gralco/GLCD/README.md

Reimplementation of the RepRapDiscount Full Graphic Smart Controller in KiCad
