gralco/GLCD/BoM/GLCD.csv

Reference | Value | Footprint | Datasheet | MFG Name | MFG Part Num | Distrib PN | Distrib Link | Tolerance | Others | More | MFG Link | Drawing
Q1 | BC817-40 | TO_SOT_Packages_SMD:SOT-23_Handsoldering | http://www.diodes.com/_files/datasheets/ds11107.pdf | Diodes Incorporated | BC817-40-7-F | 621-BC817-40-7-F | http://www.mouser.com/ProductDetail/Diodes-Incorporated/BC817-40-7-F/?qs=rGAXPo9uwV11o%252bqBQVUw0g%3D%3D
SP1 | SPEAKER | Buzzers_Beepers:Buzzer_12x9.5RM7.6 | http://www.puiaudio.com/pdf/AI-1223-TWT-5V-R.pdf | CUI | AI-1223-TWT-5V-R | 665-AI-1223TWT5VR | http://www.mouser.com/ProductDetail/PUI-Audio/AI-1223-TWT-5V-R/?qs=hFHXi4OlQrkyrRn%252bNLipFQ%3D%3D | - | http://www.mouser.com/Electromechanical/Audio-Devices/Audio-Indicators-Alerts/_/N-awp3t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
IC1 | 74HC4050 | SMD_Packages:SO-16-N | http://www.nxp.com/documents/data_sheet/74HC4050.pdf | Texas Instruments | CD74HC4050M96 | 595-CD74HC4050M96 | http://www.mouser.com/ProductDetail/Texas-Instruments/CD74HC4050M96/
EXP2 | CONN_02X05 | Connect:IDC_Header_Straight_10pins | http://multimedia.3m.com/mws/media/22504O/3mtm-100-in-loprof-hdr-100x-100strt-ra-4-wall-ts0818.pdf | 3M Electronic Solutions Division | 30310-6002HB | 517-30310-6002 | http://www.mouser.com/ProductDetail/3M-Electronic-Solutions-Division/30310-6002HB/ | - | http://www.mouser.com/Connectors/Headers-Wire-Housings/_/N-ay0lo | http://www.digikey.com/product-search/en/connectors-interconnects/rectangular-connectors-headers-male-pins/1442547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
C1 | 100nF | Capacitors_SMD:C_0805_HandSoldering | http://datasheets.avx.com/X7RDielectric.pdf | AVX | 08055C104KAT2A | 581-08055C104K | http://www.mouser.com/ProductDetail/AVX/08055C104KAT2A/ | 10% | http://www.mouser.com/Passive-Components/Capacitors/Ceramic-Capacitors/MLCCs-Multilayer-Ceramic-Capacitors/Multilayer-Ceramic-Capacitors-MLCC-SMD-SMT/_/N-bkrd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
R1 | 1kΩ | Resistors_SMD:R_0805_HandSoldering | http://www.vishay.com/docs/20035/dcrcwe3.pdf | Vishay / Dale | CRCW08051K00FKEA | 71-CRCW0805-1.0K-E3 | http://www.mouser.com/ProductDetail/Vishay-Dale/CRCW08051K00FKEA/ | 1% | http://www.mouser.com/Passive-Components/Resistors/SMD-Resistors-Chip-Resistors/Thick-Film-Resistors/_/N-7h7yz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
EXP1 | CONN_02X05 | Connect:IDC_Header_Straight_10pins | http://multimedia.3m.com/mws/media/22504O/3mtm-100-in-loprof-hdr-100x-100strt-ra-4-wall-ts0818.pdf | 3M Electronic Solutions Division | 30310-6002HB | 517-30310-6002 | http://www.mouser.com/ProductDetail/3M-Electronic-Solutions-Division/30310-6002HB/ | - | http://www.mouser.com/Connectors/Headers-Wire-Housings/_/N-ay0lo | http://www.digikey.com/product-search/en/connectors-interconnects/rectangular-connectors-headers-male-pins/1442547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
U1 | MIC5209-3.3YS | TO_SOT_Packages_SMD:SOT-223 | http://ww1.microchip.com/downloads/en/DeviceDoc/mic5209.pdf | Micrel | MIC5209-3.3YS-TR | 998-MIC5209-3.3YSTR | http://www.mouser.com/ProductDetail/Microchip-Technology-Micrel/MIC5209-33YS-TR/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
C3 | 100nF | Capacitors_SMD:C_0805_HandSoldering | http://datasheets.avx.com/X7RDielectric.pdf | AVX | 08055C104KAT2A | 581-08055C104K | http://www.mouser.com/ProductDetail/AVX/08055C104KAT2A/ | 10% | http://www.mouser.com/Passive-Components/Capacitors/Ceramic-Capacitors/MLCCs-Multilayer-Ceramic-Capacitors/Multilayer-Ceramic-Capacitors-MLCC-SMD-SMT/_/N-bkrd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
C4 | 1uF | Capacitors_SMD:C_1206_HandSoldering | http://www.vishay.com/docs/28548/vjw1bcbascomseries.pdf | Vishay | VJ1206Y105JXJTW1BC | 77-VJ1206Y105JXJTBC | http://www.mouser.com/ProductDetail/Vishay-Vitramon/VJ1206Y105JXJTW1BC/ | 5% | http://www.mouser.com/Passive-Components/Capacitors/_/N-5g7r?P=1z0wrj5Z1yzmotyZ1z0x6fr
DS1 | LCD_Panel | Pin_Headers:Pin_Header_Straight_1x20 | http://www.buydisplay.com/download/manual/ERM12864-6_Series_Datasheet.pdf | Sitronix/LCD China | ST7920 | ERM12864SBS-6 | http://www.buydisplay.com/default/lcd-display-serial-graphic-display-128x64-st7920-white-on-blue
RBL1 | 68Ω | Resistors_SMD:R_0805_HandSoldering | http://industrial.panasonic.com/cdbs/www-data/pdf/RDA0000/AOA0000C84.pdf | Panasonic | ERJ-6GEYJ680V | 667-ERJ-6GEYJ680V | http://www.mouser.com/ProductDetail/Panasonic/ERJ-6GEYJ680V/ | 5% | http://www.mouser.com/Passive-Components/Resistors/SMD-Resistors-Chip-Resistors/Thick-Film-Resistors/_/N-7h7yz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
EN1 | EC11E15244B2 | GLCD:Rotary_Encoder | http://www.alps.com/prod/info/E/PDF/Switch/Encoder/EC11/EC11.PDF | ALPS | EC11E15244B2 | 688-EC11E15244B2 | http://www.mouser.com/ProductDetail/ALPS/EC11E15244B2/?qs=m0BA540hBPfDpUEkDmFV5A%3D%3D
C2 | 100nF | Capacitors_SMD:C_0805_HandSoldering | http://datasheets.avx.com/X7RDielectric.pdf | AVX | 08055C104KAT2A | 581-08055C104K | http://www.mouser.com/ProductDetail/AVX/08055C104KAT2A/ | 10% | http://www.mouser.com/Passive-Components/Capacitors/Ceramic-Capacitors/MLCCs-Multilayer-Ceramic-Capacitors/Multilayer-Ceramic-Capacitors-MLCC-SMD-SMT/_/N-bkrd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
Z1 | ZENER_4_CHANNEL | GLCD:SOT-666 | http://www.semtech.com/images/datasheet/uclamp0504a.pdf | Semtech | UCLAMP0504A.TCT | 947-UCLAMP0504A.TCT | http://www.mouser.com/ProductDetail/Semtech/UCLAMP0504ATCT/?qs=rBWM4%252bvDhIfEUuo6cYGUyg%3D%3D | - | http://www.digikey.com/product-search/en/circuit-protection/tvs-diodes/655429
SD1 | SD_CARD | GLCD:SD_Card_Receptacle | http://www.te.com/commerce/DocumentDelivery/DDEController?Action=showdoc | TE Connectivity | 2041021-4 | 571-2041021-4 | http://www.mouser.com/ProductDetail/TE-Connectivity/2041021-4/?qs=TL6PIybY3BNBwMuwjqQ%252bqw%3D%3D | - | - | - | http://www.te.com/commerce/DocumentDelivery/DDEController?Action=selcritrslt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 | http://www.te.com/commerce/DocumentDelivery/DDEController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
