gralco/GLCD/BoM/GLCD.ods

Reference | Value | Footprint | Datasheet | AO Part # | MFG Name | MFG Part Num | Distributor | Distrib PN | Qty Per | Price Per | Price total | Qty to Order | PO | ETA | Notes | Distrib Link | Tolerance
 |  |  |  |  |  |  |  |  |  |  |  | 3
PCB | LB_GLCD | N/A |  | PC-BD0057 | OSH Park | N/A | OSH Park | N/A | 1 | 20.9666666667 | 62.9 | 3 | PO15577 |  |  | https://oshpark.com/
DS1 | LCD_PANEL | Pin_Headers:Pin_Header_Straight_1x20 | http://www.buydisplay.com/download/manual/ERM12864-6_Series_Datasheet.pdf | EL-MS0417 | Sitronix | ST7920 | BuyDisplay.com | ERM12864FS-6 | 1 | 8.41 | 25.23 | 3 |  |  |  | http://www.buydisplay.com/default/graphic-module-128x64-serial-lcd-display-st7920-black-on-white
BMP1 | BUMPER | N/A | http://multimedia.3m.com/mws/media/117314O/3m-bumpon-protective-products-molded-shapes-colored-and-clear.pdf | HD-MS0369 | 3M Electronic Solutions Division | SJ61A1 | Digi-Key | SJ5746-0-ND | 3 | 0.0984 | 14.1696 | 144 |  |  | MOQ of 144 | http://www.digikey.com/product-detail/en/3m/SJ61A1/SJ5746-0-ND/1768456
DS1 | CONN_01X20 | Pin_Headers:Pin_Header_Straight_1x20 | http://multimedia.3m.com/mws/media/548112O/3mtm-pin-strip-header-ts2181.pdf | EL-MS0389 | 3M Electronic Solutions Division | 961120-6404-AR | Mouser Electronics | 517-9611206404AR | 1 | 1.34 | 4.02 | 3 |  |  |  | http://www.mouser.com/ProductDetail/3M-Electronic-Solutions-Division/961120-6404-AR/
SD1 | SD_CARD | GLCD:SD_Card_Receptacle | http://www.te.com/commerce/DocumentDelivery/DDEController?Action=showdoc | EL-MS0263 | TE Connectivity | 2041021-4 | Mouser Electronics | 571-2041021-4 | 1 | 2.74 | 8.22 | 3 |  |  |  | http://www.mouser.com/ProductDetail/TE-Connectivity/2041021-4/?qs=TL6PIybY3BNBwMuwjqQ%252bqw%3D%3D
EN1 | EC11E15244B2 | GLCD:Rotary_Encoder | http://www.alps.com/prod/info/E/PDF/Switch/Encoder/EC11/EC11.PDF | EL-MS0400 | ALPS | EC11E15244B2 | Mouser Electronics | 688-EC11E15244B2 | 1 | 6.68 | 20.04 | 3 |  |  |  | http://www.mouser.com/ProductDetail/ALPS/EC11E15244B2/?qs=m0BA540hBPfDpUEkDmFV5A%3D%3D
SP1 | SPEAKER | Buzzers_Beepers:Buzzer_12x9.5RM7.6 | http://www.puiaudio.com/pdf/AI-1223-TWT-5V-R.pdf | EL-MS0419 | CUI | AI-1223-TWT-5V-R | Mouser Electronics | 665-AI-1223TWT5VR | 1 | 3.65 | 10.95 | 3 |  |  |  | http://www.mouser.com/ProductDetail/PUI-Audio/AI-1223-TWT-5V-R/?qs=hFHXi4OlQrkyrRn%252bNLipFQ%3D%3D
EXP1/EXP2 | CONN_02X05 | GLCD:IDC_Header_Straight_10pins_slot_at_6 | http://multimedia.3m.com/mws/media/22504O/3mtm-100-in-loprof-hdr-100x-100strt-ra-4-wall-ts0818.pdf | EL-MS0402 | 3M Electronic Solutions Division | 30310-6002HB | Mouser Electronics | 517-30310-6002 | 2 | 0.64 | 3.84 | 6 |  |  |  | http://www.mouser.com/ProductDetail/3M-Electronic-Solutions-Division/30310-6002HB/
U1 | MIC5209-3.3YS | TO_SOT_Packages_SMD:SOT-223 | http://ww1.microchip.com/downloads/en/DeviceDoc/mic5209.pdf | EL-MS0403 | Micrel | MIC5209-3.3YS-TR | Mouser Electronics | 998-MIC5209-3.3YSTR | 1 | 1.43 | 4.29 | 3 |  |  |  | http://www.mouser.com/ProductDetail/Microchip-Technology-Micrel/MIC5209-33YS-TR/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
IC1 | 74HC4050 | SMD_Packages:SO-16-N | http://www.nxp.com/documents/data_sheet/74HC4050.pdf | EL-MS0404 | Texas Instruments | CD74HC4050M96 | Mouser Electronics | 595-CD74HC4050M96 | 1 | 0.43 | 1.29 | 3 |  |  |  | http://www.mouser.com/ProductDetail/Texas-Instruments/CD74HC4050M96/
Q1 | BC817-40 | TO_SOT_Packages_SMD:SOT-23_Handsoldering | http://www.diodes.com/_files/datasheets/ds11107.pdf | EL-MS0405 | Diodes Incorporated | BC817-40-7-F | Mouser Electronics | 621-BC817-40-7-F | 1 | 0.2 | 0.6 | 3 |  |  |  | http://www.mouser.com/ProductDetail/Diodes-Incorporated/BC817-40-7-F/?qs=rGAXPo9uwV11o%252bqBQVUw0g%3D%3D
Z1 | ZENER_4_CHANNEL | GLCD:SOT-666 | http://www.semtech.com/images/datasheet/uclamp0504a.pdf | EL-MS0435 | Semtech | UCLAMP0504A.TCT | Mouser Electronics | 947-UCLAMP0504A.TCT | 1 | 0.79 | 2.37 | 3 |  |  |  | http://www.mouser.com/ProductDetail/Semtech/UCLAMP0504ATCT/?qs=rBWM4%252bvDhIfEUuo6cYGUyg%3D%3D
RBL1 | 68Ω | Resistors_SMD:R_0805_HandSoldering | http://industrial.panasonic.com/cdbs/www-data/pdf/RDA0000/AOA0000C84.pdf | EL-MS0406 | Panasonic | ERJ-6GEYJ680V | Mouser Electronics | 667-ERJ-6GEYJ680V | 1 | 0.1 | 0.3 | 3 |  |  |  | http://www.mouser.com/ProductDetail/Panasonic/ERJ-6GEYJ680V/ | 5%
R1 | 1KΩ | Resistors_SMD:R_0805_HandSoldering | http://www.vishay.com/docs/20035/dcrcwe3.pdf | EL-MS0407 | Vishay / Dale | CRCW08051K00FKEA | Mouser Electronics | 71-CRCW0805-1.0K-E3 | 1 | 0.1 | 0.3 | 3 |  |  |  | http://www.mouser.com/ProductDetail/Vishay-Dale/CRCW08051K00FKEA/ | 1%
C1/C2/C3 | 100nF | Capacitors_SMD:C_0805_HandSoldering | http://datasheets.avx.com/X7RDielectric.pdf | EL-MS0408 | AVX | 08055C104KAT2A | Mouser Electronics | 581-08055C104K | 3 | 0.1 | 0.9 | 9 |  |  |  | http://www.mouser.com/ProductDetail/AVX/08055C104KAT2A/ | 10%
C4 | 1uF | Capacitors_SMD:C_1206_HandSoldering | http://www.vishay.com/docs/28548/vjw1bcbascomseries.pdf | EL-MS0433 | Vishay | VJ1206Y105JXJTW1BC | Mouser Electronics | 77-VJ1206Y105JXJTBC | 1 | 0.11 | 0.33 | 3 |  |  |  | http://www.mouser.com/ProductDetail/Vishay-Vitramon/VJ1206Y105JXJTW1BC/ | 5%
