gralco/GLCD/GLCD.fcstd

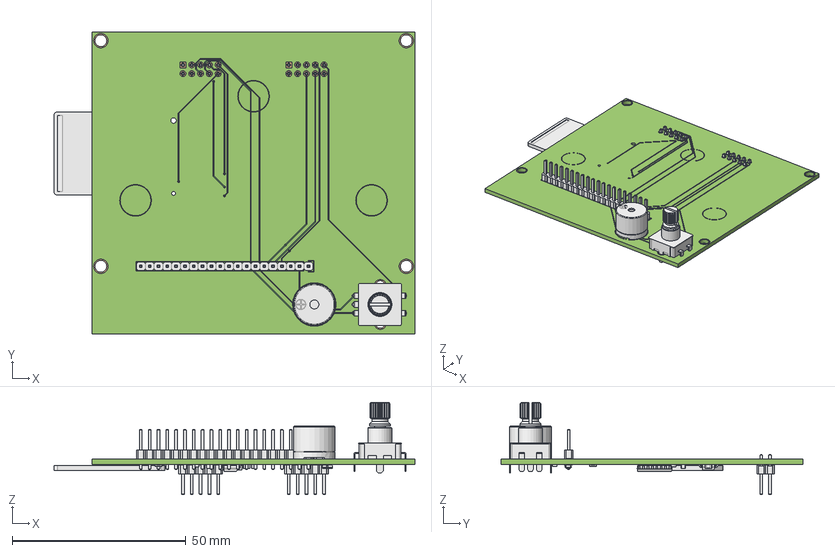
[picture p1: CAD file, 2017-10-08]
GLCD.fcstd
104.0 x 87.0 x 26.6 mm
Board
C1
C2
C3
C4
R1
RBL1
IC1
U1
Q1
SP1
EN1
DS1
EXP2
EXP1
SD1
F_Cu_0
bPad_107
tPad_108
B_Cu_31
B_SilkS_36
F_SilkS_37
