gralco/GLCD/(list of files, cad)

Other CAD files:
GLCD_wrl.fcstd
