gralco/GLCD/GLCD.pdf

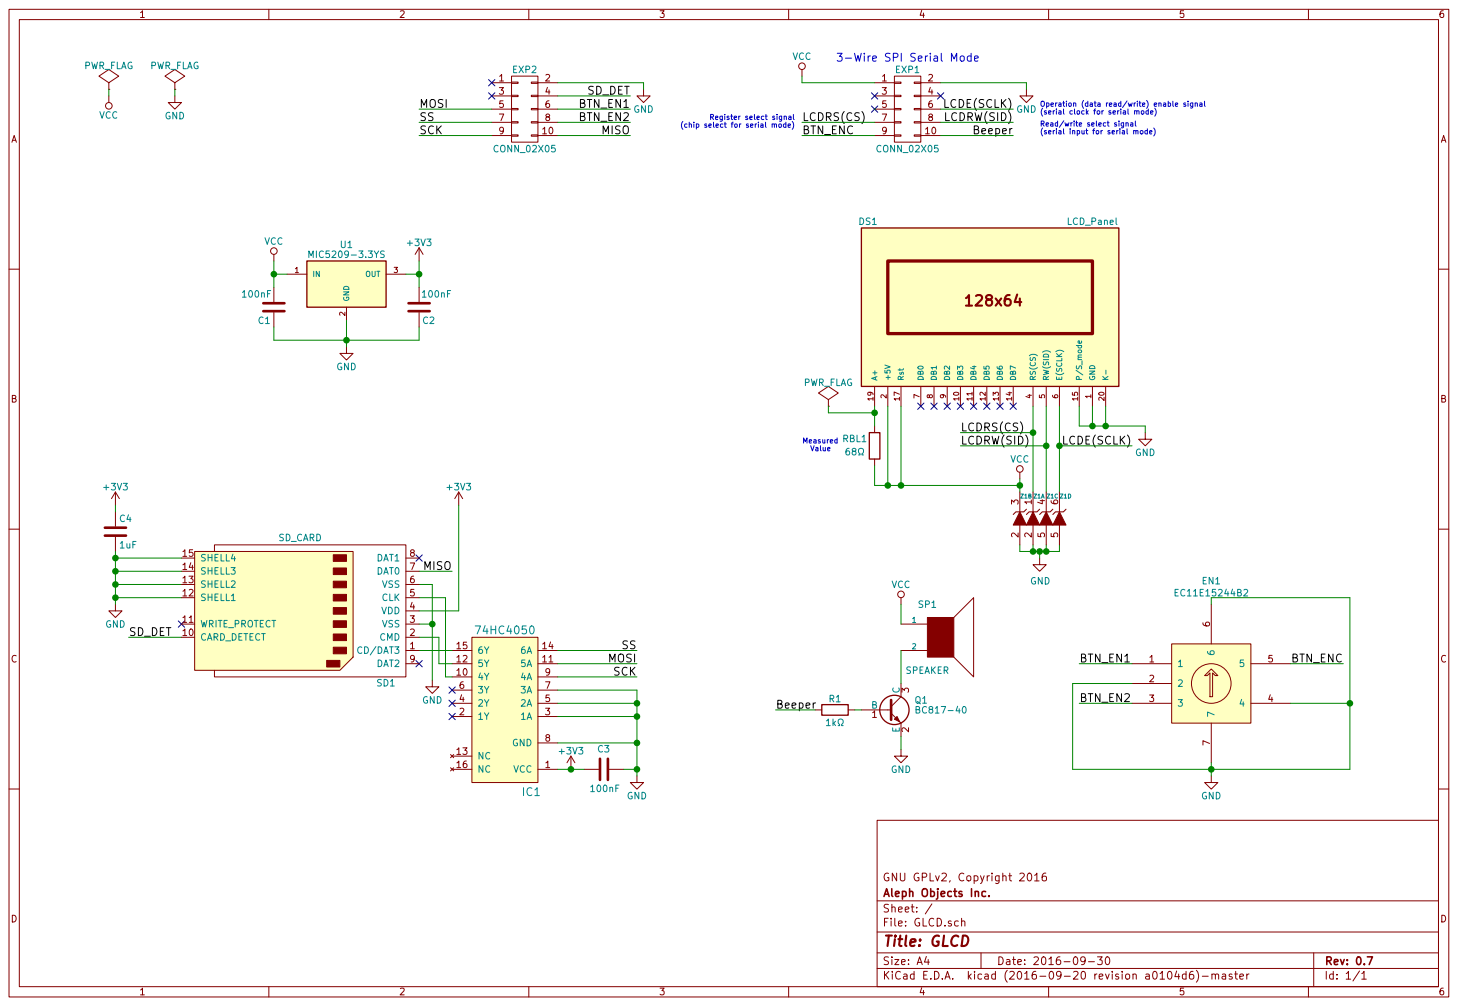
[picture p2: page 1]

2 RS(CS) 4 RW(SID) 5 E(SCLK) 6 DB0

1 2 Z1A 2 3 Z1B 4 5 Z1C5 6 Z1D CD/DAT3 1 CMD 2 VSS 3 VDD 4 CLK 5 VSS 6 DAT0 7 DAT1 8 DAT2 9 CARD_DETECT 10 WRITE_PROTECT 11 SHELL1 12 SHELL2 13 SHELL3 14 SHELL4 15 SD1 SD_CARD

File: GLCD.sch Sheet: / Aleph Objects Inc.
