gralco/GLCD/GLCD.kicad_pcb

## KiCad design GLCD.kicad_pcb (2017-10-08)

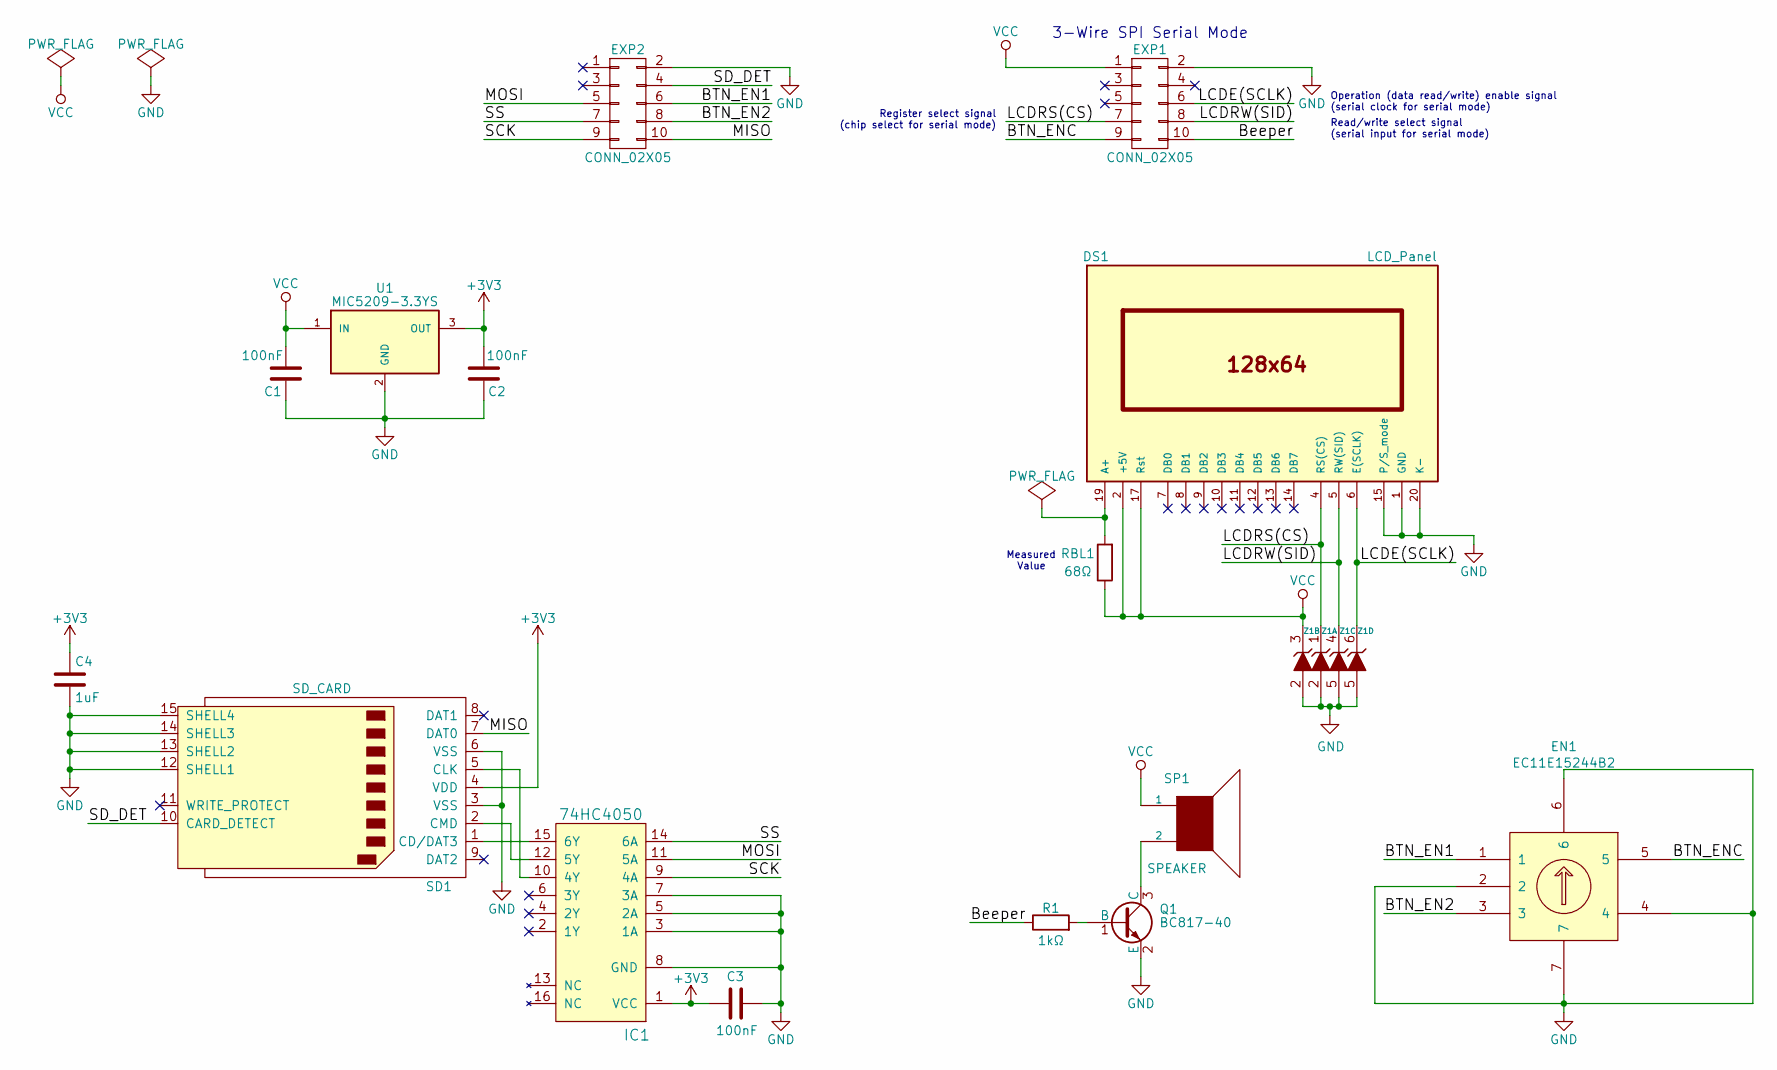
[picture p3: schematic GLCD.sch]

Parts:
C1, C2, C3: 100nF; C_0805_HandSoldering; Tolerance 10%; MFG Part Num 08055C104KAT2A
C4: 1uF; C_1206_HandSoldering; Tolerance 5%; MFG Part Num VJ1206Y105JXJTW1BC
DS1: LCD_Panel; Pin_Header_Straight_1x20; MFG Part Num ST7920
EN1: EC11E15244B2; Rotary_Encoder; MFG Part Num EC11E15244B2
EXP1, EXP2: CONN_02X05; IDC_Header_Straight_10pins; MFG Part Num 30310-6002HB
IC1: 74HC4050; SO-16-N; MFG Part Num CD74HC4050M96
Q1: BC817-40; SOT-23_Handsoldering; MFG Part Num BC817-40-7-F
R1: 1kΩ; R_0805_HandSoldering; Tolerance 1%; MFG Part Num CRCW08051K00FKEA
RBL1: 68Ω; R_0805_HandSoldering; Tolerance 5%; MFG Part Num ERJ-6GEYJ680V
SD1: SD_CARD; SD_Card_Receptacle; MFG Part Num 2041021-4
SP1: SPEAKER; Buzzer_12x9.5RM7.6; MFG Part Num AI-1223-TWT-5V-R
U1: MIC5209-3.3YS; SOT-223; MFG Part Num MIC5209-3.3YS-TR
Z1: ZENER_4_CHANNEL; SOT-666; MFG Part Num UCLAMP0504A.TCT

Connections:
+3V3: C2.1, C3.1, C4.1, IC1.1 (VCC), SD1.4 (VDD), U1.3 (OUT)
/BTN_EN1: EN1.1, EXP2.6
/BTN_EN2: EN1.3, EXP2.8
/BTN_ENC: EN1.5, EXP1.9
/Beeper: EXP1.10, R1.1
/LCDE(SCLK): DS1.6 (E(SCLK)), EXP1.6, Z1.6 (K)
/LCDRS(CS): DS1.4 (RS(CS)), EXP1.7, Z1.1 (K)
/LCDRW(SID): DS1.5 (RW(SID)), EXP1.8, Z1.4 (K)
/MISO: EXP2.10, SD1.7 (DAT0)
/MOSI: EXP2.5, IC1.11 (5A)
/SCK: EXP2.9, IC1.9 (4A)
/SD_DET: EXP2.4, SD1.10 (CARD_DETECT)
/SS: EXP2.7, IC1.14 (6A)
GND: C1.2, C2.2, C3.2, C4.2, DS1.1 (GND), DS1.15 (P/S_mode), DS1.20 (K-), EN1.2, EN1.4, EN1.6, EN1.7, EXP1.2, EXP2.2, IC1.3 (1A), IC1.5 (2A), IC1.7 (3A), IC1.8 (GND), Q1.2 (E), SD1.3 (VSS), SD1.6 (VSS), SD1.12 (SHELL1), SD1.13 (SHELL2), SD1.14 (SHELL3), SD1.15 (SHELL4), U1.2 (GND), U1.4, Z1.2 (A), Z1.5 (A)
unnamed: DS1.19 (A+), RBL1.2
unnamed: IC1.10 (4Y), SD1.5 (CLK)
unnamed: IC1.12 (5Y), SD1.2 (CMD)
unnamed: IC1.15 (6Y), SD1.1 (CD/DAT3)
unnamed: Q1.1 (B), R1.2
unnamed: Q1.3 (C), SP1.2
VCC: C1.1, DS1.2 (+5V), DS1.17 (Rst), EXP1.1, RBL1.1, SP1.1, U1.1 (IN), Z1.3 (K)

Notes on the sheet:
Operation (data read/write) enable signal (serial clock for serial mode)
Read/write select signal (serial input for serial mode)
Register select signal (chip select for serial mode)
3-Wire SPI Serial Mode
Measured Value

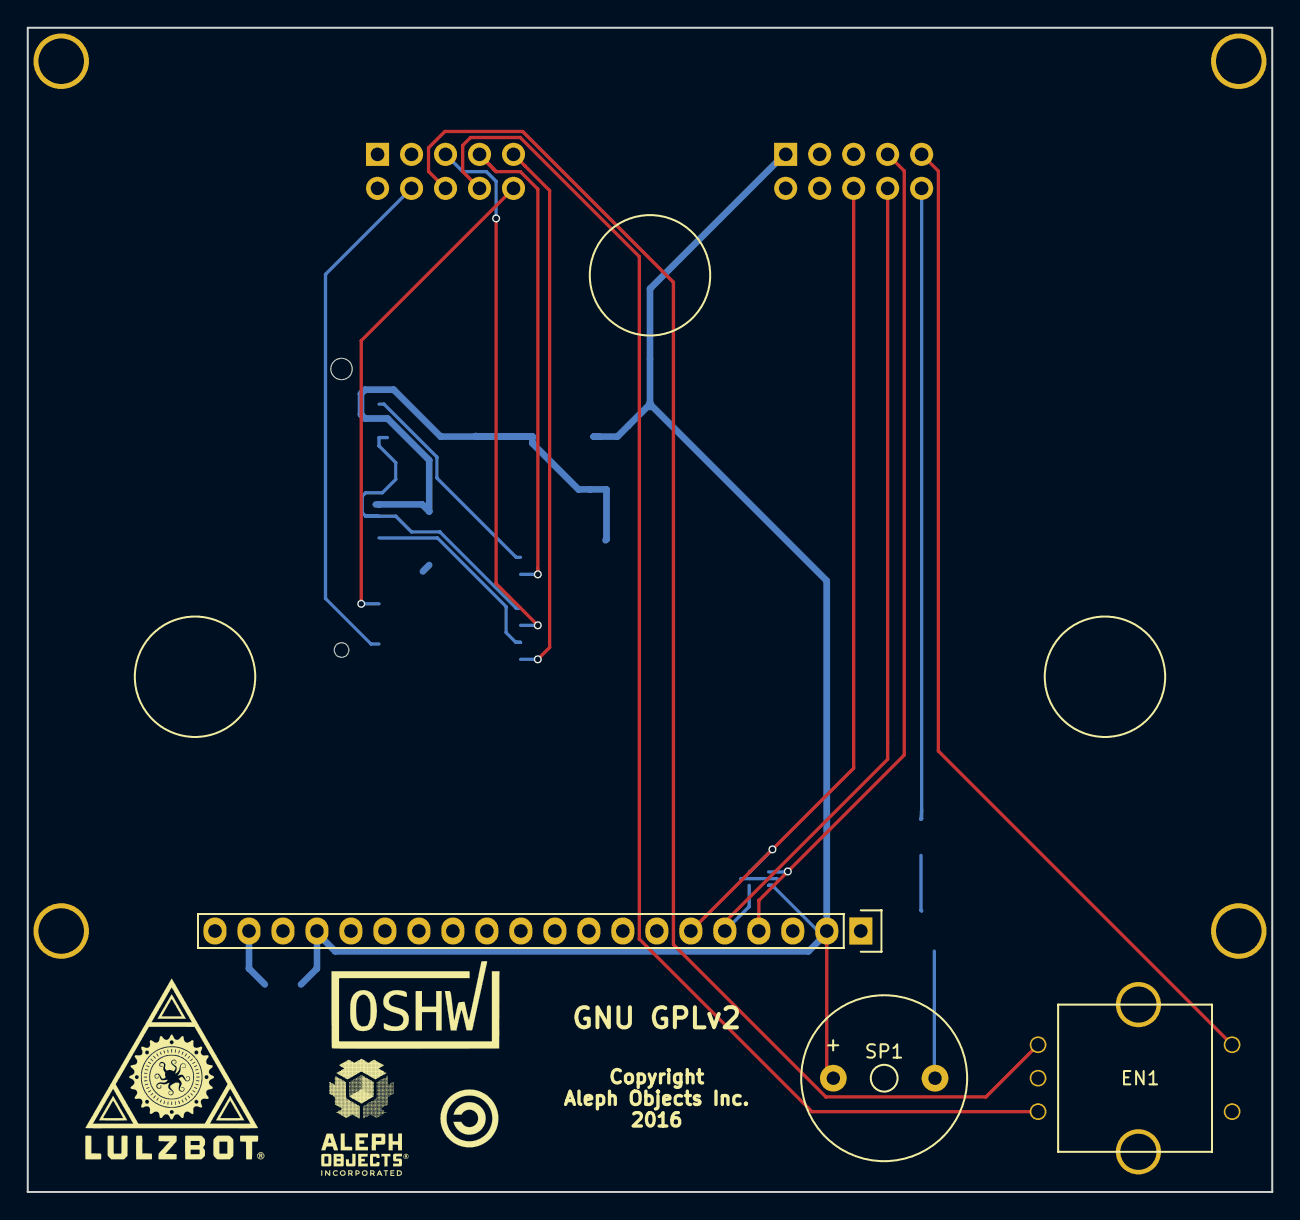
[picture p4: board GLCD.kicad_pcb from above]

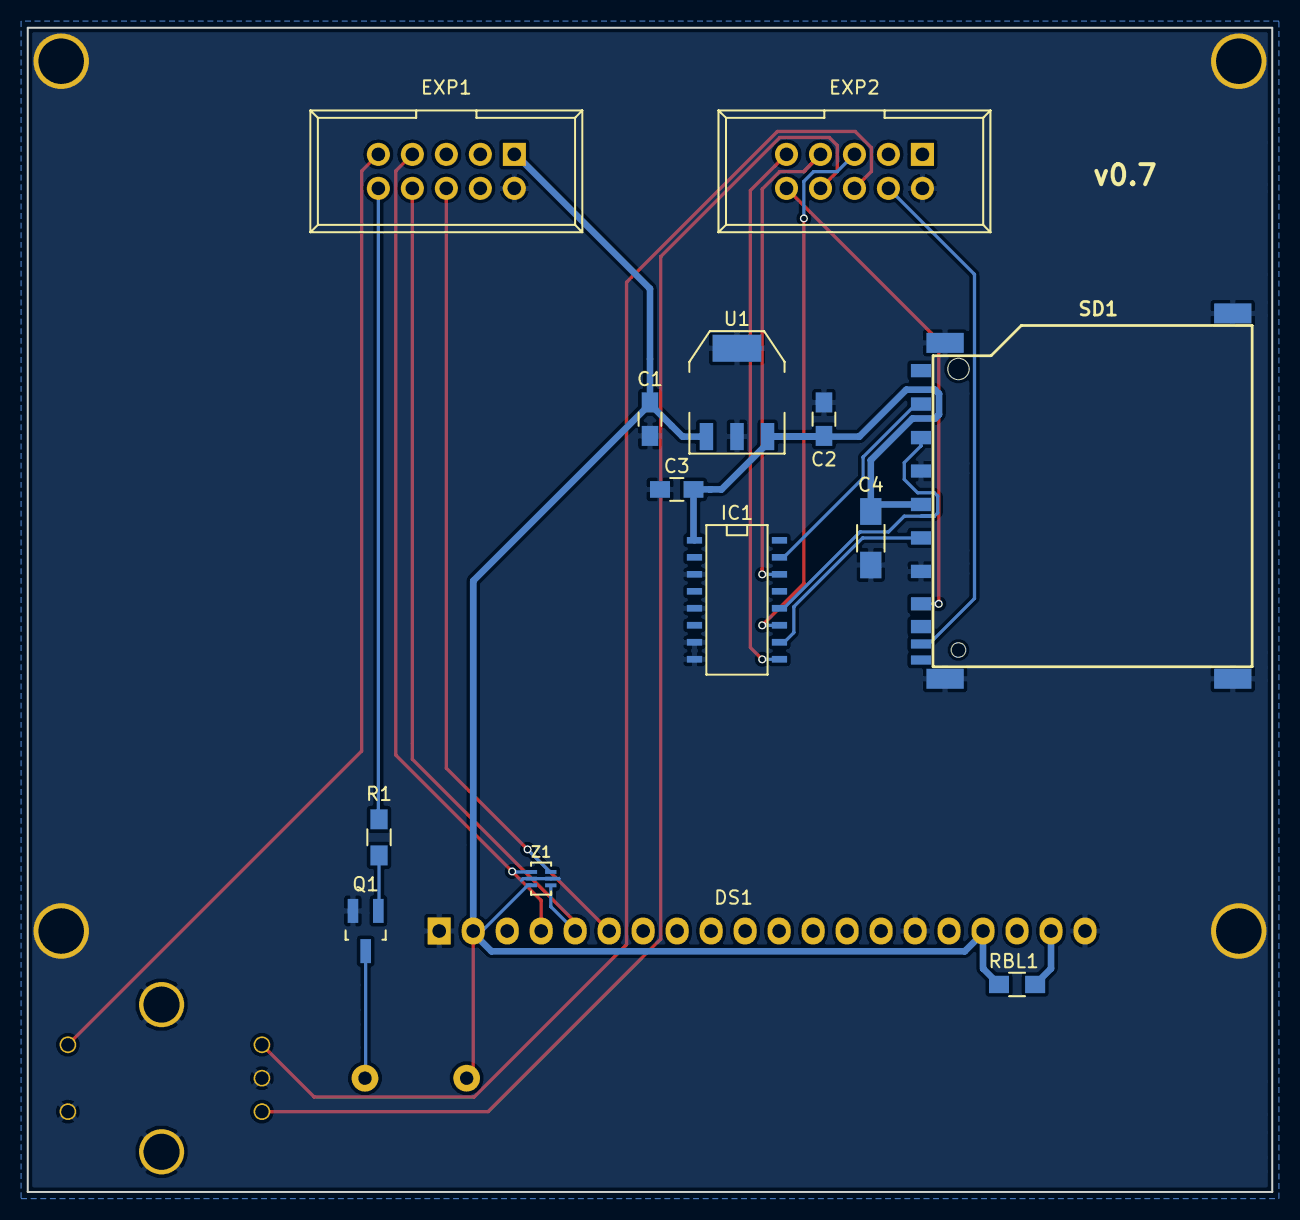
[picture p5: board GLCD.kicad_pcb from below]

Board: 2 copper layers, 93.0 x 87.0 mm, 16 parts (13 on the bottom side), 21 nets.
