gralco/GLCD/(notices)

Notices in the files:
GLCD.sch:
GNU GPLv2, Copyright 2016
GLCD.kicad_pcb:
GNU GPLv2
